sinoagg/SMU_Circuit/ReadMe.txt

SMU源测量单元

Version：2.03
Date:07/10/2018
1.在采集量程电阻和待测器件时接入两路JFET输出的运放，降低bias current造成的影响。
2.重新将仪放8253变为可调100倍及1000倍的情况。
3.去掉前端8244的电阻调节放大倍数，用处不大。
4.将SENSE_H SENSE_L的连接顺序变为和原来一致，否则反馈方向相反，设计错误。
5.调整钽电容为3216型，减小布线难度。

Version: 2.02
Date: 06/26/2018
1.在8422的输出端加一个电阻（电容额外备用），以减小因负载电容产生的振荡。
2.将反馈输出通过电阻分压调小进行平衡调节，而不是直接通过调节输入电压进行平衡调节。运放在远离零电压时平衡能力不理想。
3.增加平衡运放密勒电容，做超前补偿，增大相位裕量，但减小了带宽。
4.增加两个继电器D11和D16去调节反馈的电压，如果电压较小，继电器断开，反馈的也是小电压；如果电压较大，继电器闭合，反馈的仍然是小电压。
5.修改SENSE_H和SENSE_L接入顺序，使得偏置电流差正负抵消，防止测量大电阻的DUT时，导致测量范围缩小受限。
6.PGA只用10倍放大功能，其原来单片机引脚留给新增的继电器使用。
7.修改一些PCB布局布线不合理的地方。

Version：2.01 
Date：03/22/2018
1.修正LED灯没有串联电阻错误
2.在FORCE HI 和 FORCE LO端增加继电器，保证初始化及断开的时候无任何电压电流输出。
3.增加屏蔽罩接地焊接点通孔焊盘，方便焊接。
4.修改部分电阻精度要求以使输出和测量精度提高。
5.修改部分不合理的电阻阻值以符合稳定性要求。主要替换R10为1M，C20为1uF。
6.DAC输出增加偏置电路，允许FORCE HI输出负压。
7.采集到的DUT和量程电阻上增加多种分压选择，可使测量精度增加。
8.此功能未实现。//将两个AD8137单端转差分的/PD引脚使用，供零点校准时使用。
9.去掉ADR127的1.25V参考电压芯片，改由ADR441的2.5V经分压得到。保持采样和电压偏置采用同一个参考源，减少校准难度和工作量，降低成本。
10.在FORCE HI和SENSE HI之间增加1K电阻，在FORCE LO和SENSE LO之间增加1K电阻，以适配四线或两线测量。
11.增加RS485地线共地选择电阻R66，可以通过焊接或者非焊接此电阻调整共地。

Version：2.00 初始版本
