sinoagg/SMU_Circuit/(list of files, drawings)

Other design files:
Analog.SchDoc
MCU.SchDoc
Power.SchDoc
SMU_V2.02.PrjPcb
SMU_V2.03.PcbDoc
SMU_V2.03.PrjPcb
